andrisgauracs/high-five-robot/docs/media/cad_hologram.jpg

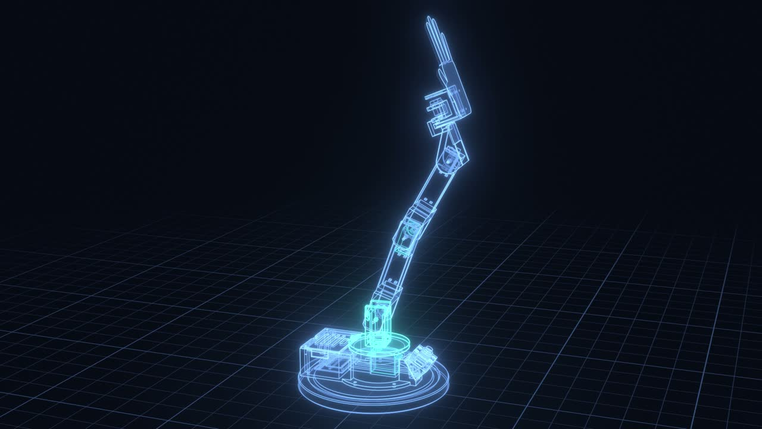
docs/media/cad_hologram.jpg
