andrisgauracs/high-five-robot/print/camera_box/plate_camera_v5_wedge_box_lid.3mf

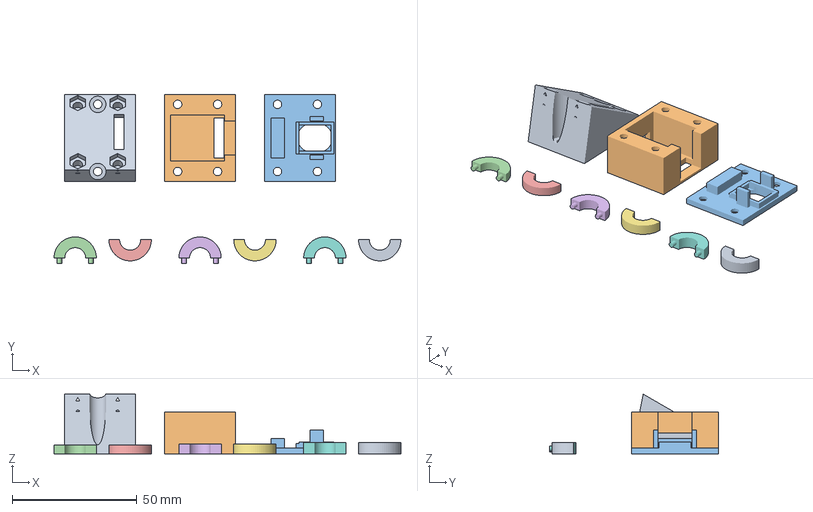
[picture p4: CAD file, 2026-11-05]
print/camera_box/plate_camera_v5_wedge_box_lid.3mf
139.0 x 67.8 x 23.9 mm
camera_wedge
camera_box
camera_lid
lens_ring_35_a
lens_ring_35_b
lens_ring_40_a
lens_ring_40_b
lens_ring_45_a
lens_ring_45_b
