andrisgauracs/high-five-robot/print/stage1/plate1_fit_test.3mf

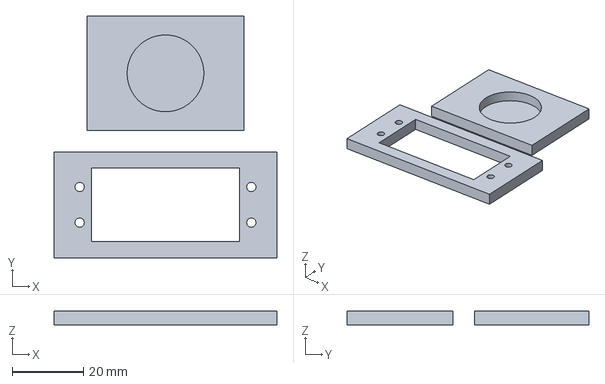
[picture p5: CAD file, 2026-11-05]
print/stage1/plate1_fit_test.3mf
62.5 x 67.7 x 4.00 mm
