andrisgauracs/high-five-robot/print/stage2/plate4b_horn_test_sideways.3mf

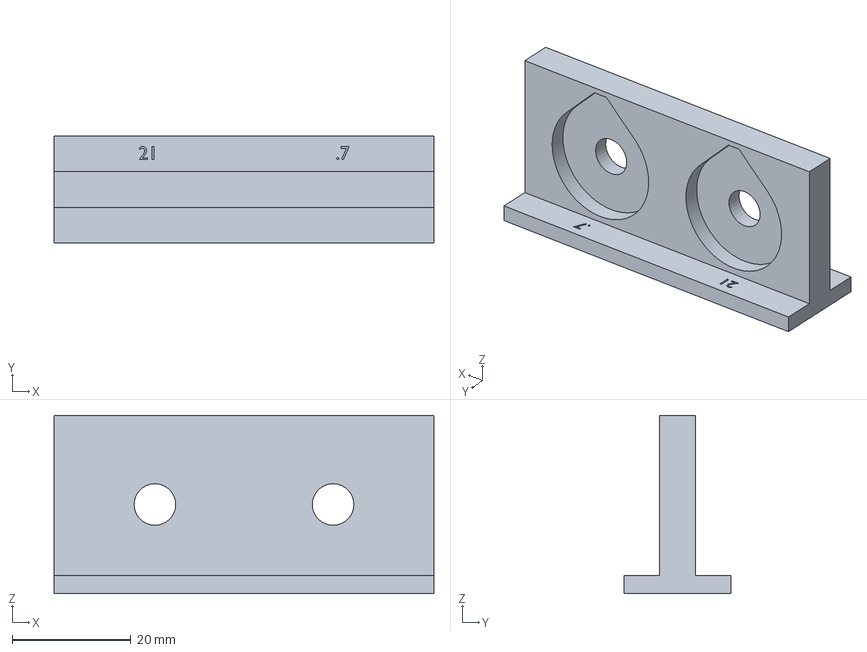
[picture p6: CAD file, 2026-11-05]
print/stage2/plate4b_horn_test_sideways.3mf
64.0 x 18.0 x 30.0 mm
