andrisgauracs/high-five-robot/print/stage3/plate2_forearm.3mf

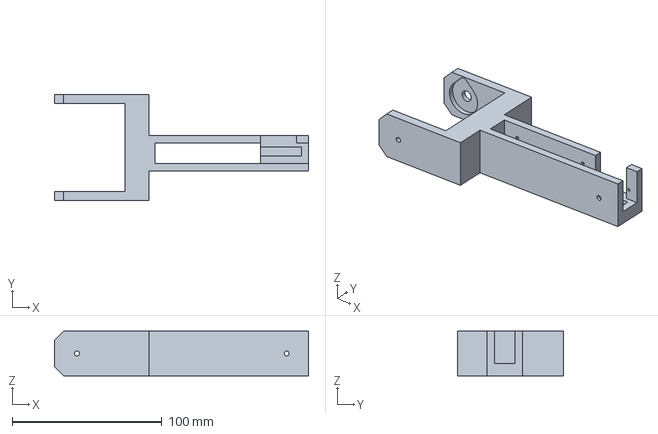
[picture p7: CAD file, 2026-11-05]
print/stage3/plate2_forearm.3mf
169.6 x 70.5 x 30.0 mm
