andrisgauracs/high-five-robot/print/stage4/plate1a_hand_only.3mf

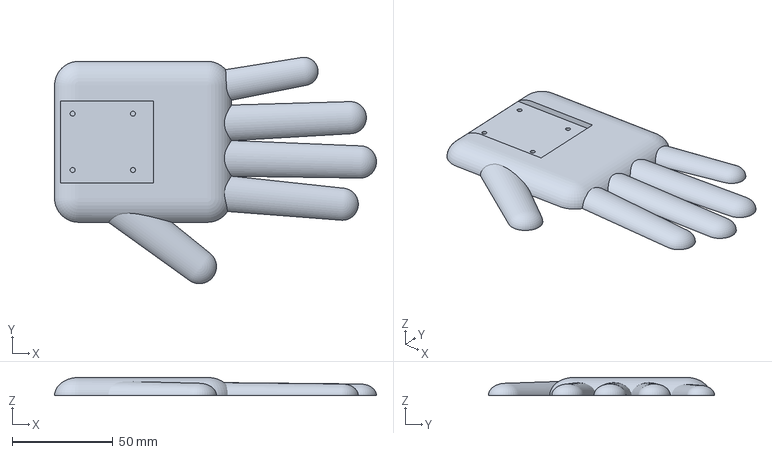
[picture p8: CAD file, 2026-11-05]
print/stage4/plate1a_hand_only.3mf
160.0 x 112.5 x 9.00 mm
