andrisgauracs/high-five-robot/stl/pan_pointer_support.stl

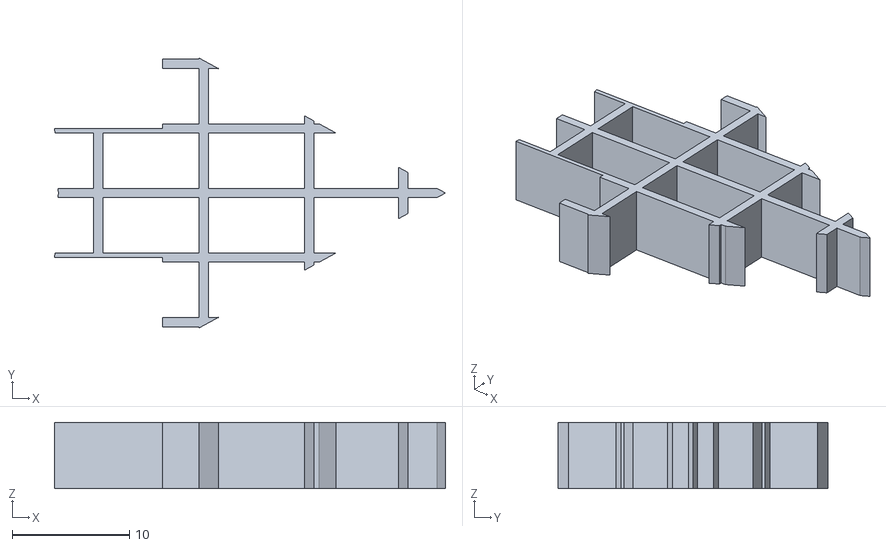
[picture p9: CAD file, 2026-11-05]
stl/pan_pointer_support.stl
33.3 x 23.0 x 5.65
