andrisgauracs/high-five-robot/print/stage1/plate3_lid_and_pointer.3mf

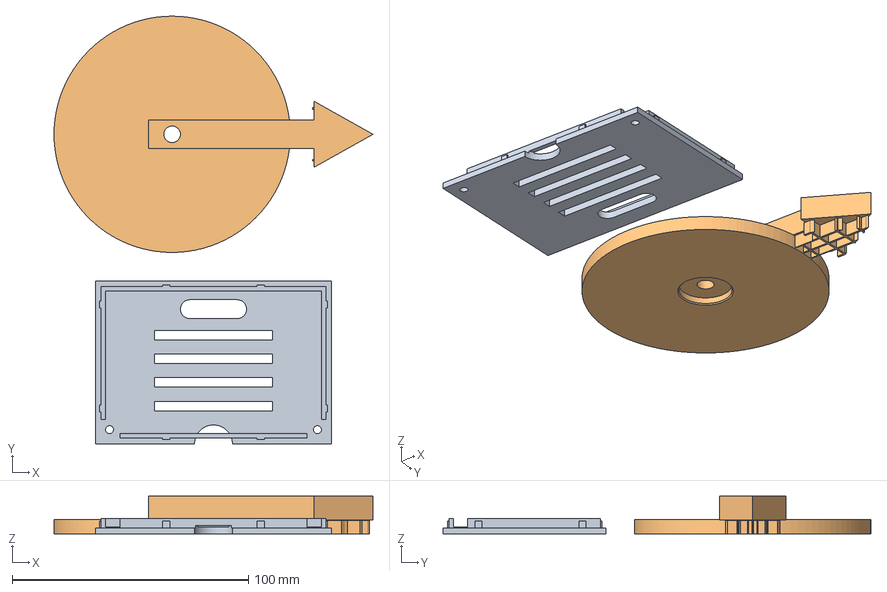
[picture p10: CAD file, 2026-11-05]
print/stage1/plate3_lid_and_pointer.3mf
135.0 x 181.0 x 16.0 mm
bay_lid
pan_pointer
