andrisgauracs/high-five-robot/print/stage2/plate4_horn_test2.3mf

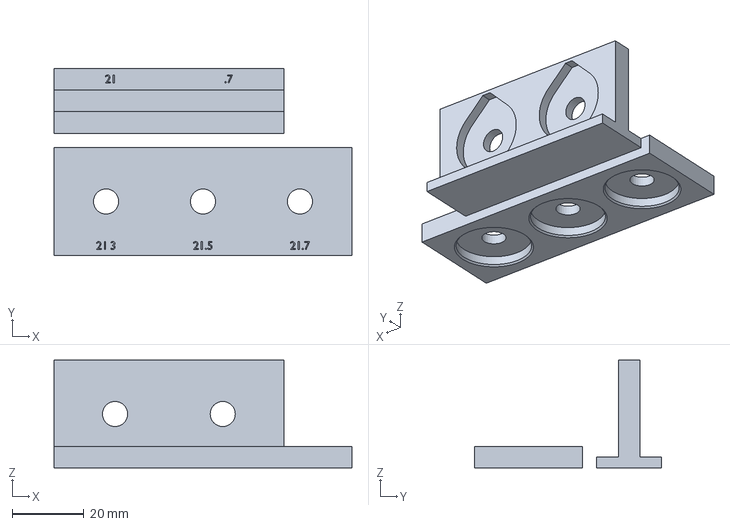
[picture p11: CAD file, 2026-11-05]
print/stage2/plate4_horn_test2.3mf
83.0 x 52.0 x 30.0 mm
