andrisgauracs/high-five-robot/print/stage3/plate1_fit_test_mg90s.3mf

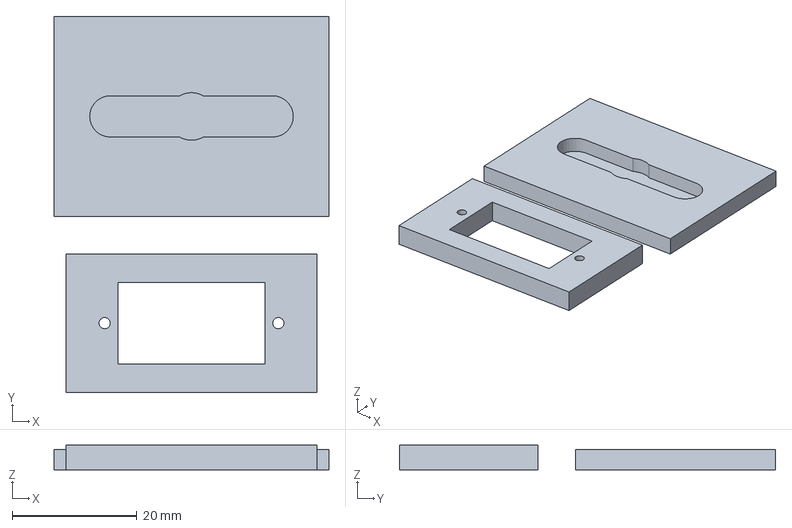
[picture p12: CAD file, 2026-11-05]
print/stage3/plate1_fit_test_mg90s.3mf
44.0 x 60.2 x 4.00 mm
