andrisgauracs/high-five-robot/print/stage4/plate1b_twist_parts_only.3mf

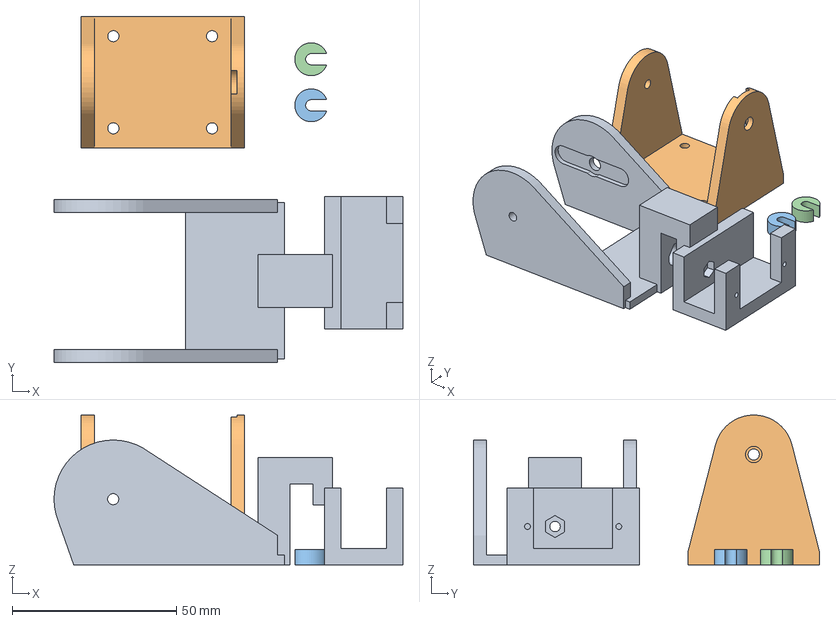
[picture p13: CAD file, 2026-11-05]
print/stage4/plate1b_twist_parts_only.3mf
106.1 x 105.2 x 45.6 mm
twist_bracket
hand_mount
pivot_spacer
pivot_spacer_2
