andrisgauracs/high-five-robot/print/stage1/plate4_lid_only.3mf

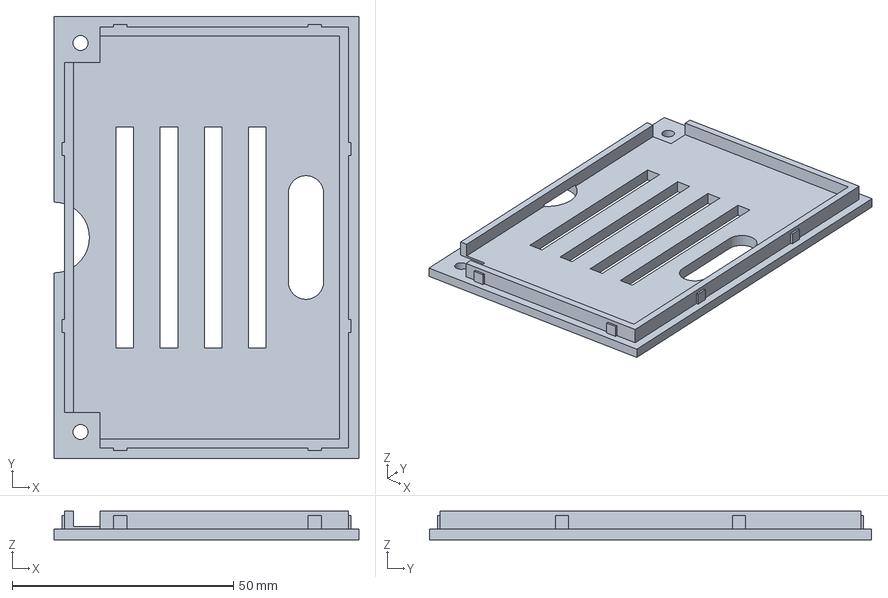
[picture p14: CAD file, 2026-11-05]
print/stage1/plate4_lid_only.3mf
69.0 x 100.0 x 6.50 mm
