andrisgauracs/high-five-robot/print/stage2/plate2_upper_arm.3mf

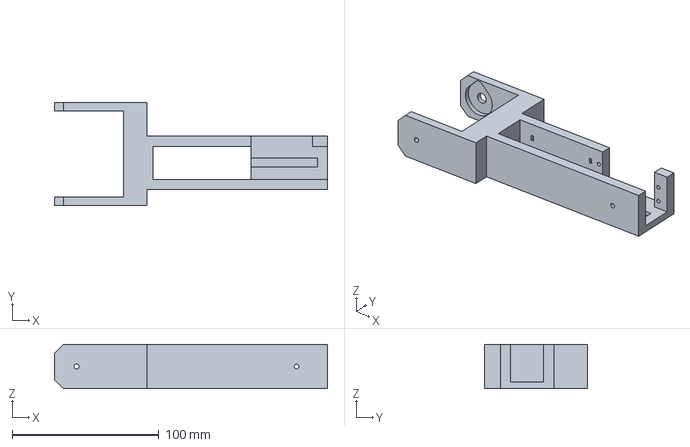
[picture p15: CAD file, 2026-11-05]
print/stage2/plate2_upper_arm.3mf
186.1 x 70.5 x 30.0 mm
