andrisgauracs/high-five-robot/print/stage4/plate1_hand_and_twist.3mf

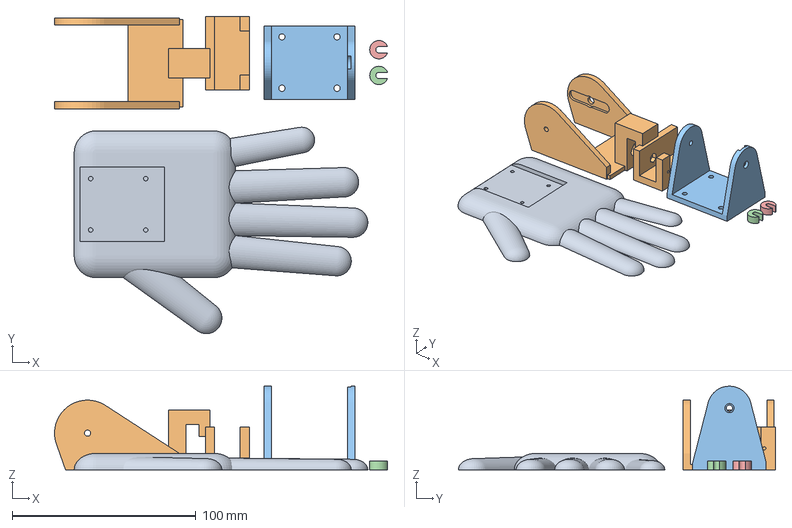
[picture p16: CAD file, 2026-11-05]
print/stage4/plate1_hand_and_twist.3mf
181.4 x 172.9 x 45.6 mm
hand
twist_bracket
hand_mount
pivot_spacer
pivot_spacer_2
