andrisgauracs/high-five-robot/stl/camera_shim_12.stl

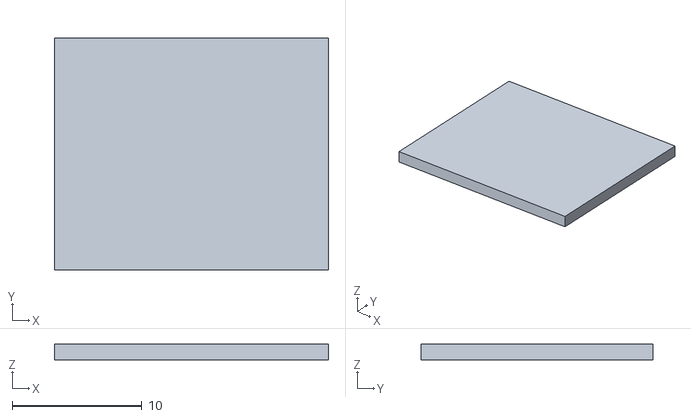
[picture p17: CAD file, 2026-11-05]
stl/camera_shim_12.stl
21.1 x 17.9 x 1.20
