andrisgauracs/high-five-robot/print/stage1/plate2_base.3mf

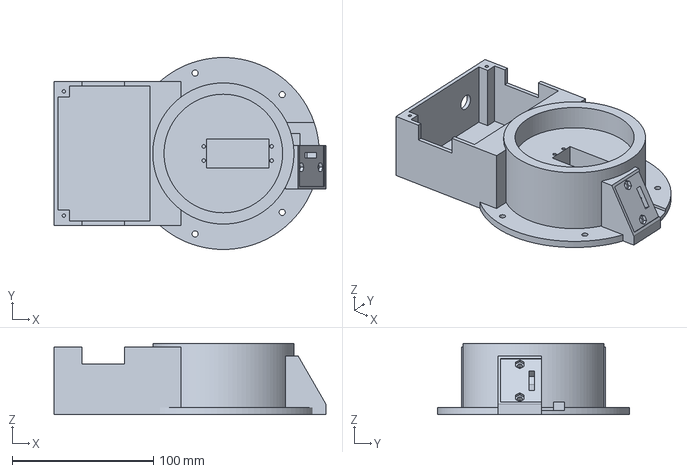
[picture p18: CAD file, 2026-11-05]
print/stage1/plate2_base.3mf
192.7 x 136.0 x 50.5 mm
