andrisgauracs/high-five-robot/print/stage2/plate3_shoulder_and_upper_arm.3mf

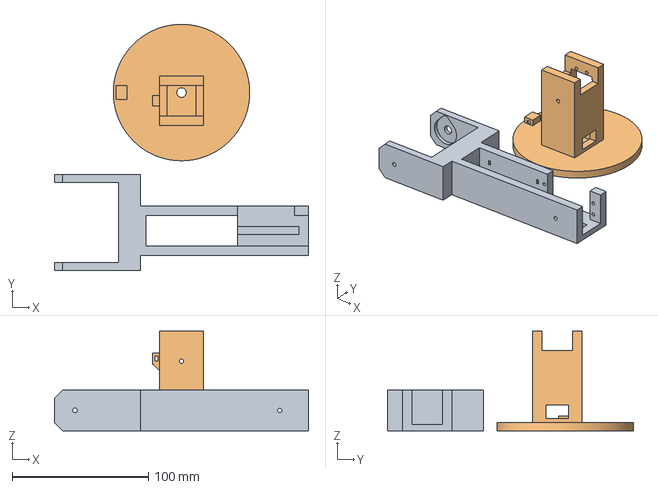
[picture p19: CAD file, 2026-11-05]
print/stage2/plate3_shoulder_and_upper_arm.3mf
186.1 x 180.5 x 73.1 mm
upper_arm
shoulder
