andrisgauracs/high-five-robot/stl/camera_lid.stl

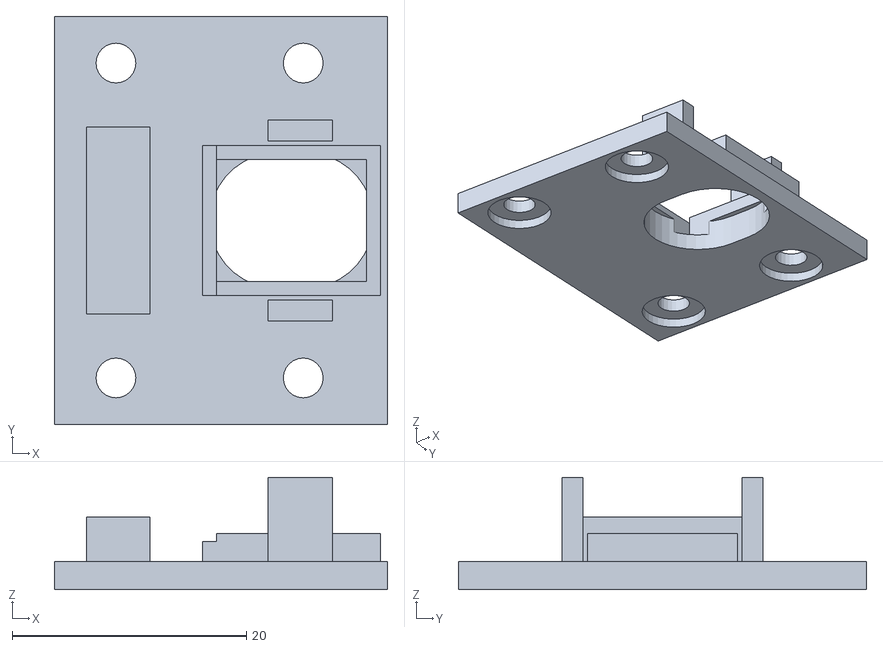
[picture p20: CAD file, 2026-11-05]
stl/camera_lid.stl
28.5 x 34.9 x 9.60
