andrisgauracs/high-five-robot/print/stage2/plate1b_shoulder_only.3mf

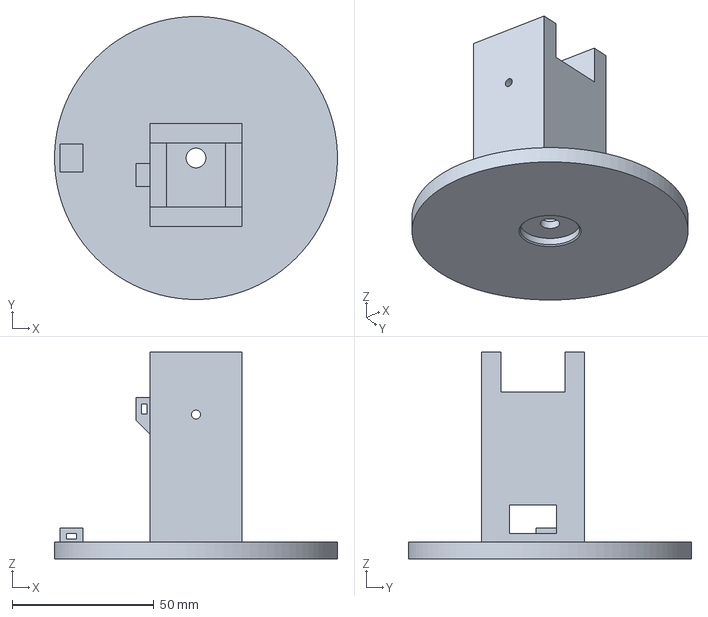
[picture p21: CAD file, 2026-11-05]
print/stage2/plate1b_shoulder_only.3mf
100.0 x 100.0 x 73.1 mm
