andrisgauracs/high-five-robot/print/stage2/plate1_shoulder_and_spacers.3mf

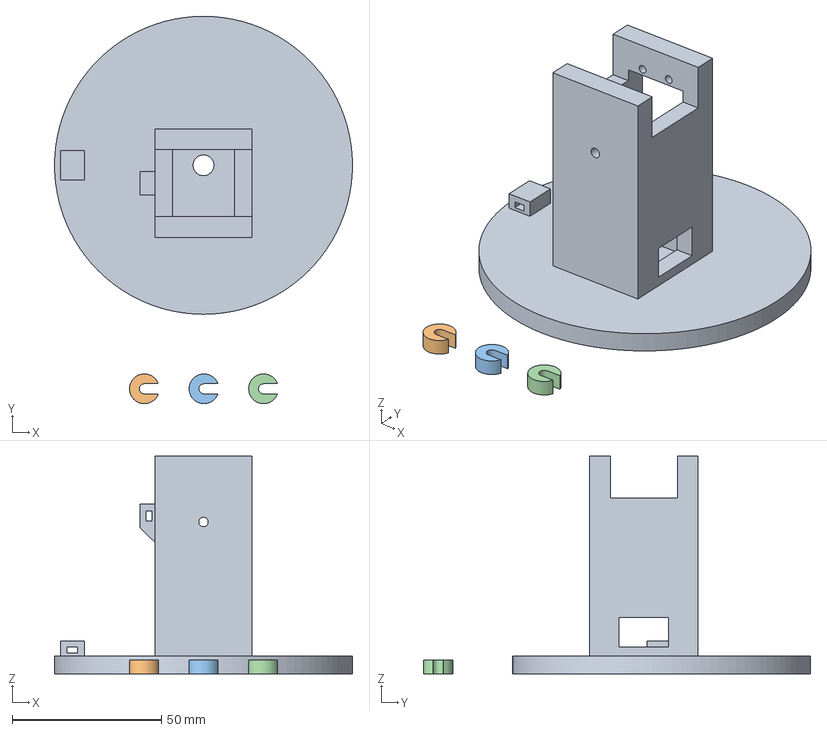
[picture p22: CAD file, 2026-11-05]
print/stage2/plate1_shoulder_and_spacers.3mf
100.0 x 130.0 x 73.1 mm
shoulder
pivot_spacer_1
pivot_spacer_2
pivot_spacer_3
