andrisgauracs/high-five-robot/stl/lens_ring_45_b.stl

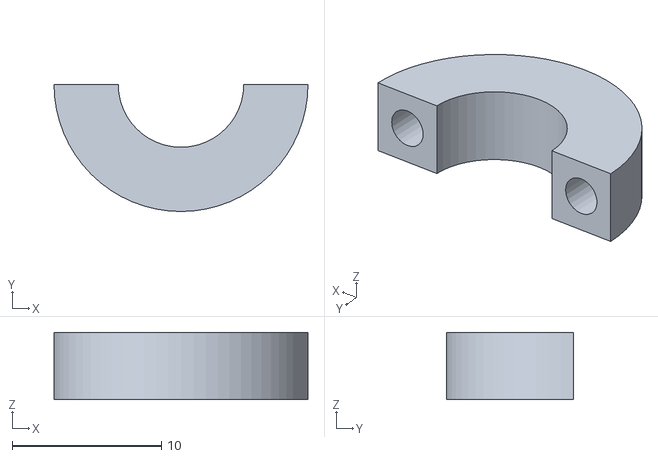
[picture p23: CAD file, 2026-11-05]
stl/lens_ring_45_b.stl
17.0 x 8.50 x 4.50
