andrisgauracs/high-five-robot/stl/pan_pointer.stl

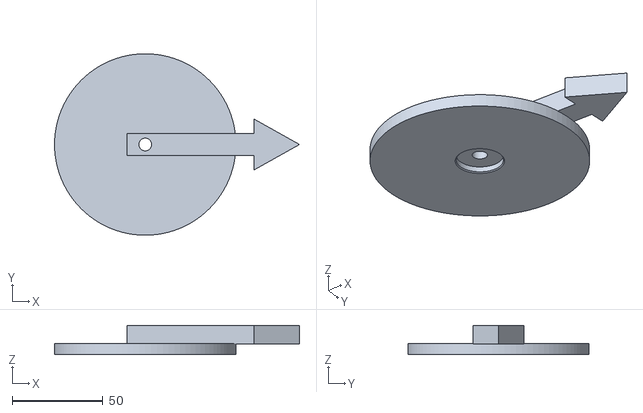
[picture p24: CAD file, 2026-11-05]
stl/pan_pointer.stl
135.0 x 100.0 x 16.0
