andrisgauracs/high-five-robot/stl/lens_ring_35_b.stl

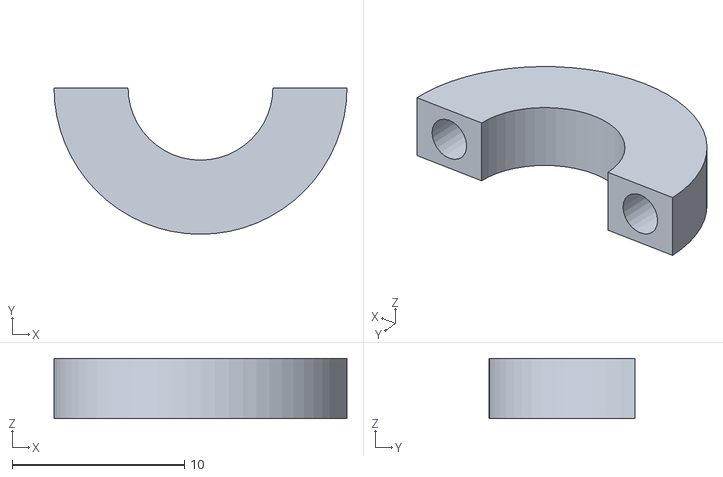
[picture p25: CAD file, 2026-11-05]
stl/lens_ring_35_b.stl
17.0 x 8.50 x 3.50
