andrisgauracs/high-five-robot/stl/camera_shim_06.stl

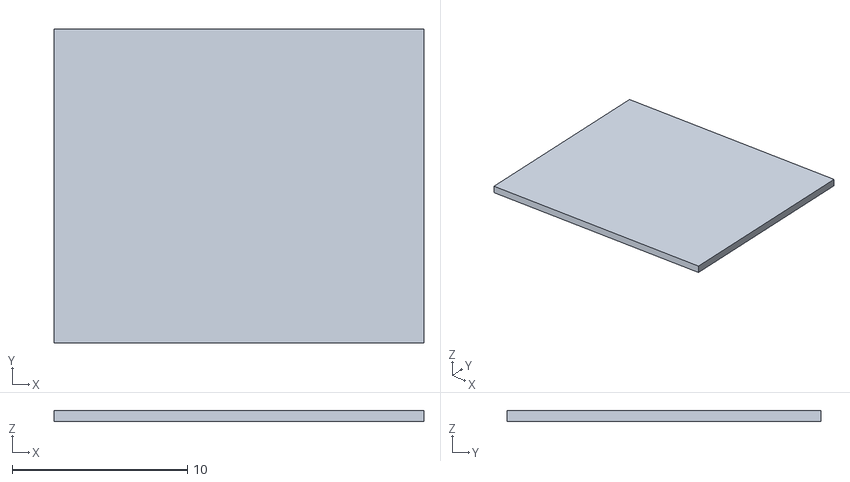
[picture p28: CAD file, 2026-11-05]
stl/camera_shim_06.stl
21.1 x 17.9 x 0.6
