andrisgauracs/high-five-robot/stl/lens_ring_35_a.stl

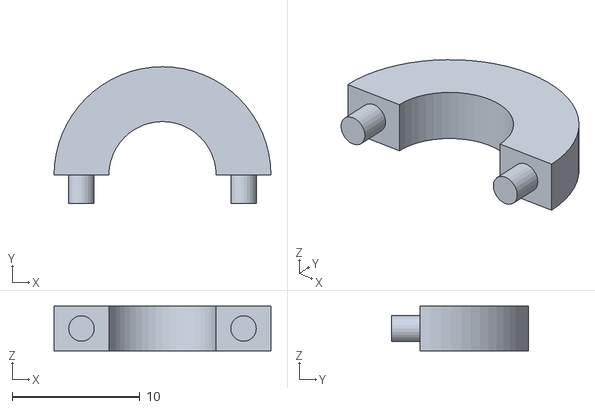
[picture p29: CAD file, 2026-11-05]
stl/lens_ring_35_a.stl
17.0 x 10.7 x 3.50
