andrisgauracs/high-five-robot/stl/twist_bracket.stl

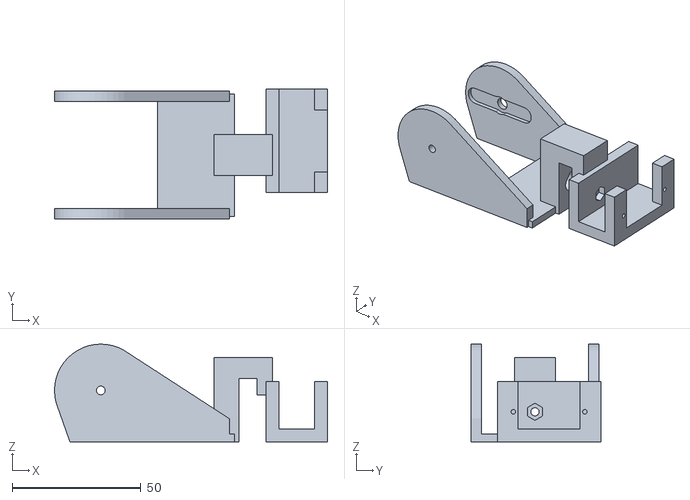
[picture p30: CAD file, 2026-11-05]
stl/twist_bracket.stl
106.1 x 50.4 x 38.0
