andrisgauracs/high-five-robot/stl/pivot_spacer.stl

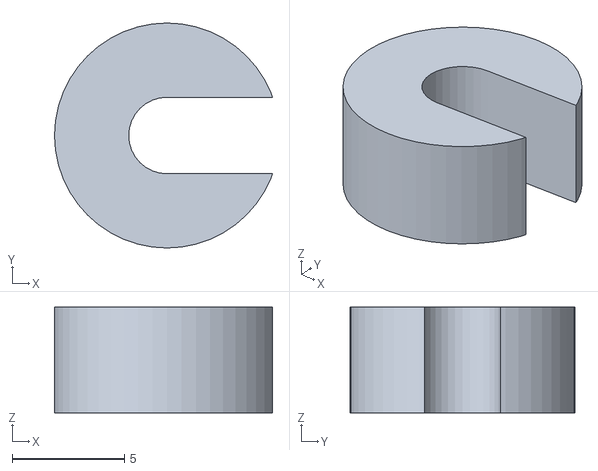
[picture p31: CAD file, 2026-11-05]
stl/pivot_spacer.stl
9.69 x 10.0 x 4.70
