andrisgauracs/high-five-robot/stl/camera_box.stl

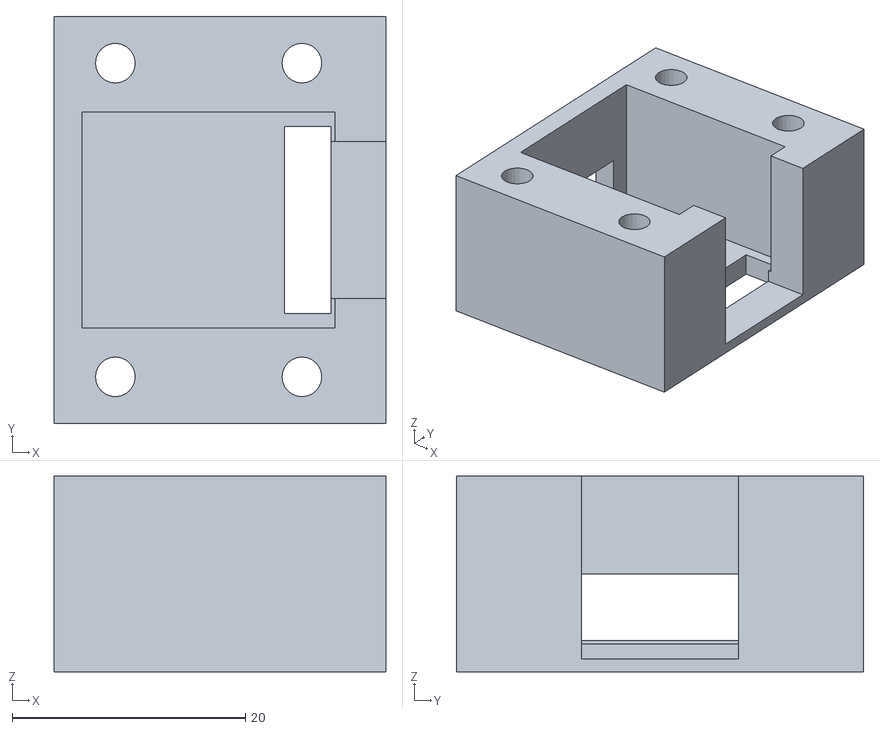
[picture p32: CAD file, 2026-11-05]
stl/camera_box.stl
28.5 x 34.9 x 16.8
