andrisgauracs/high-five-robot/stl/hand_mount.stl

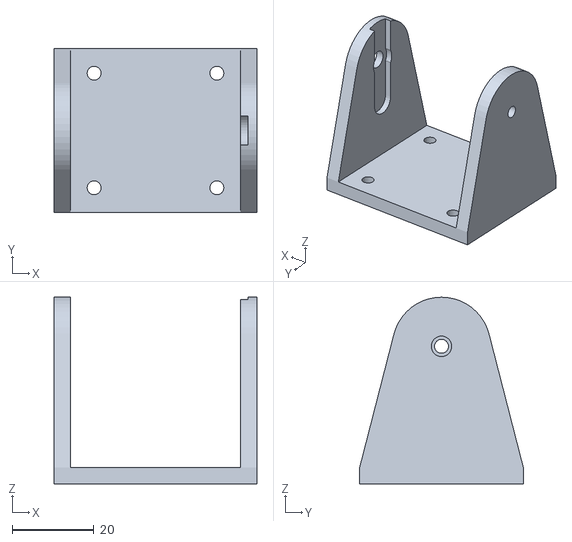
[picture p33: CAD file, 2026-11-05]
stl/hand_mount.stl
49.6 x 40.0 x 45.6
