andrisgauracs/high-five-robot/stl/camera_wedge.stl

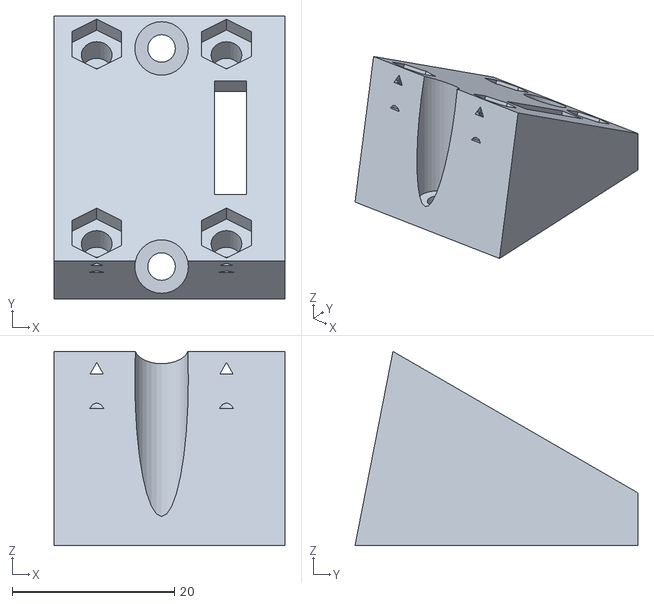
[picture p34: CAD file, 2026-11-05]
stl/camera_wedge.stl
28.4 x 34.9 x 24.0
