andrisgauracs/high-five-robot/stl/fit_test_mg995.stl

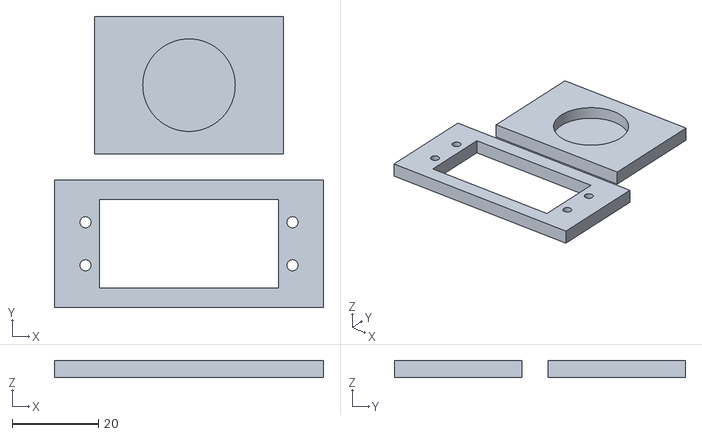
[picture p36: CAD file, 2026-11-05]
stl/fit_test_mg995.stl
62.5 x 67.7 x 4.00
