andrisgauracs/high-five-robot/(list of files, cad)

Other CAD files:
stl/forearm.stl
stl/upper_arm.stl
stl/hand.stl
stl/base.stl
stl/bay_lid.stl
stl/fit_test_mg90s.stl
stl/shoulder.stl
