andrisgauracs/high-five-robot/(commit log)

2026-11-05 Add Greg, the high-five robot: CAD, print files, firmware, tools and build guide
    [base.stl, bay_lid.stl, camera_box.stl, camera_lid.stl, camera_shim_06.stl, camera_shim_12.stl, camera_wedge.stl, fit_test_mg90s.stl]
2026-11-05 Keep LICENSE as the plain MIT text so GitHub detects it
    The Apache 2.0 note for the camera firmware stays in the README.
2026-11-05 Add a rotating wireframe GIF of Greg to the README
